YanhaoYang2/ECE-445-notebooks/README.md

# Team 9 Ant-weight 3D Printed Battlebot

A sub-2 lb antweight combat robot featuring a servo-driven lifting wedge, ESP32-S3 BLE wireless control, dual H-bridge motor drivers, and a fully 3D-printed PLA chassis: built for ECE 445 Senior Design at UIUC. The custom PCB integrates power regulation, drivetrain control, and weapon actuation into a compact, competition-ready platform.

Team members:
- Mig Umnakkittikul
- Yanhao Yang
- Yunhan Tian

## Results

[Battle Video](https://drive.google.com/file/d/1RE8FONN-sFi-dEDkxu0kXL-BYywnTr4P/view?resourcekey)

[Presentation](https://docs.google.com/presentation/d/1tjDH-47TegS7ervyMoe9hrtVM2WsI11a/edit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)

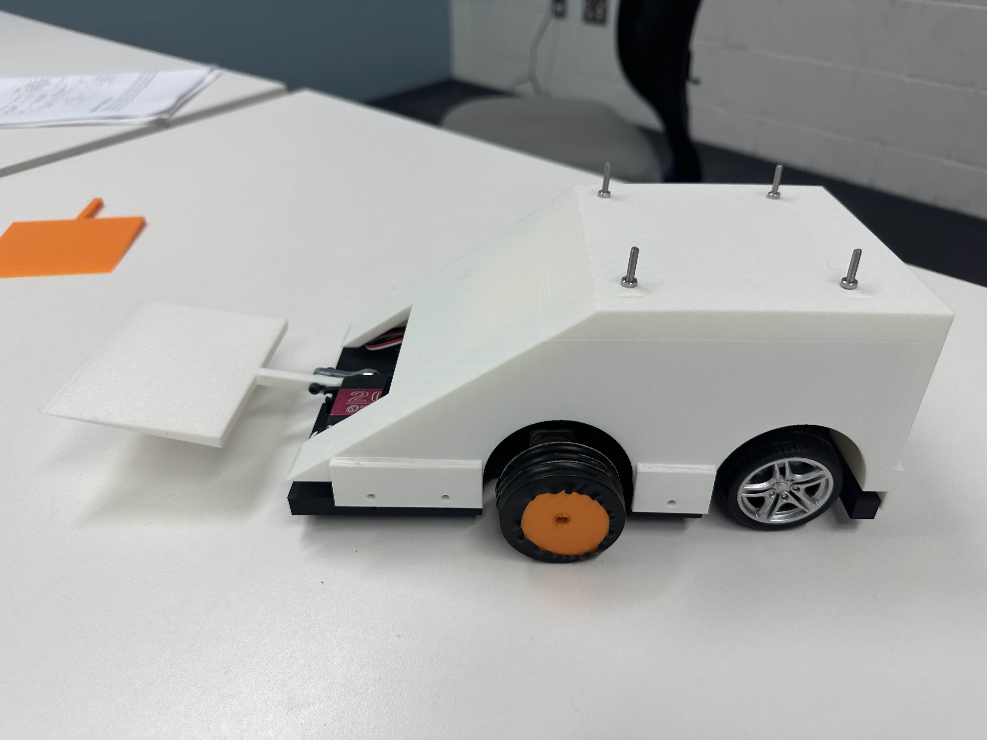
[picture p1: notebooks/Mig/finalbattlebot.jpg]
