YanhaoYang2/ECE-445-notebooks/boards/schematics/full_schematics.png

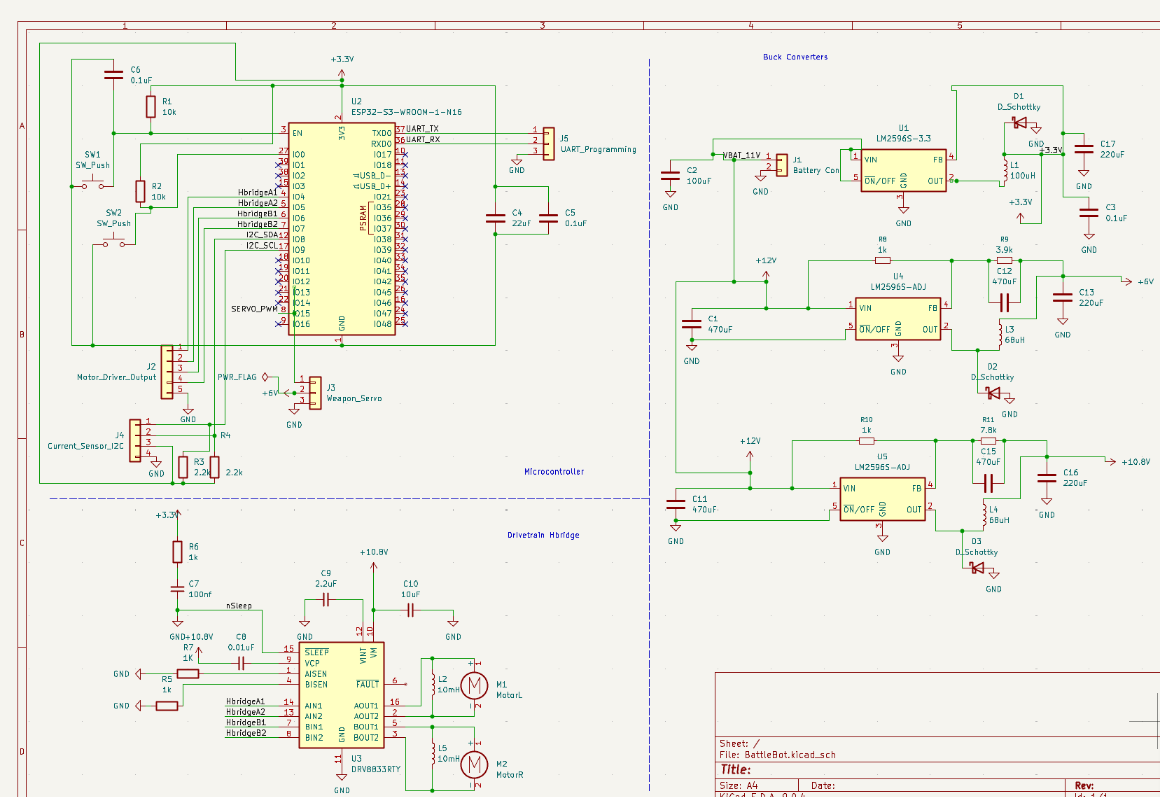
boards/schematics/full_schematics.png
