YanhaoYang2/ECE-445-notebooks/models/battlebotchassisbottom.png

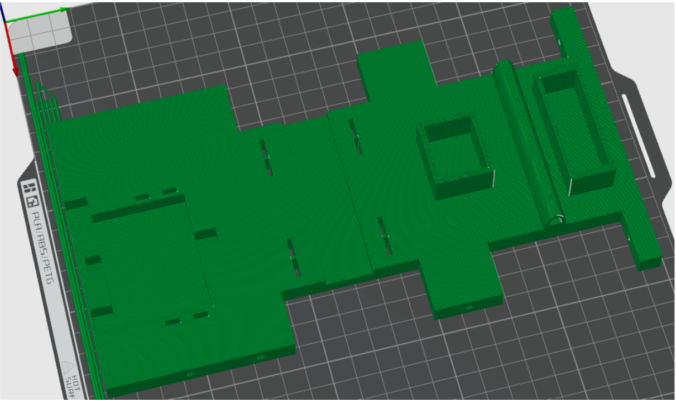
models/battlebotchassisbottom.png
