YanhaoYang2/ECE-445-notebooks/models/battlebotchassistop.png

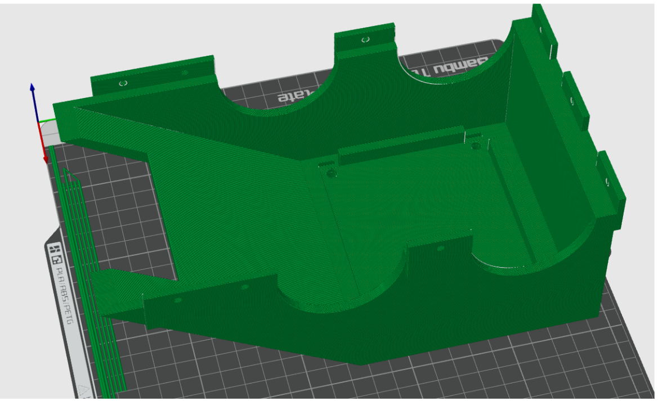
models/battlebotchassistop.png
