YanhaoYang2/ECE-445-notebooks/models/shovel_design.png

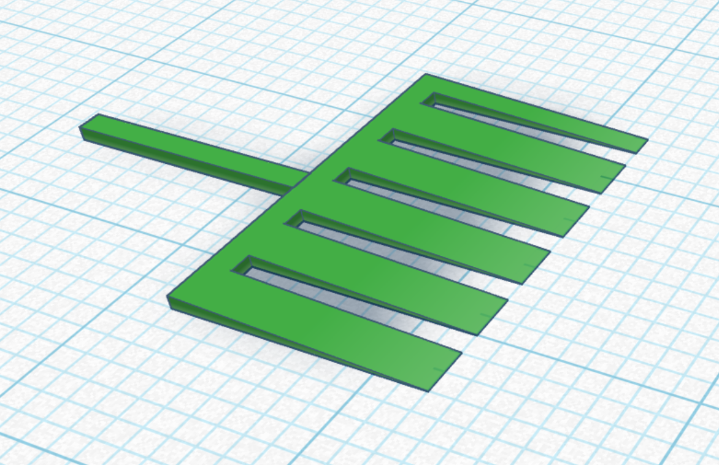
models/shovel_design.png
