YanhaoYang2/ECE-445-notebooks/models/weapon3d.png

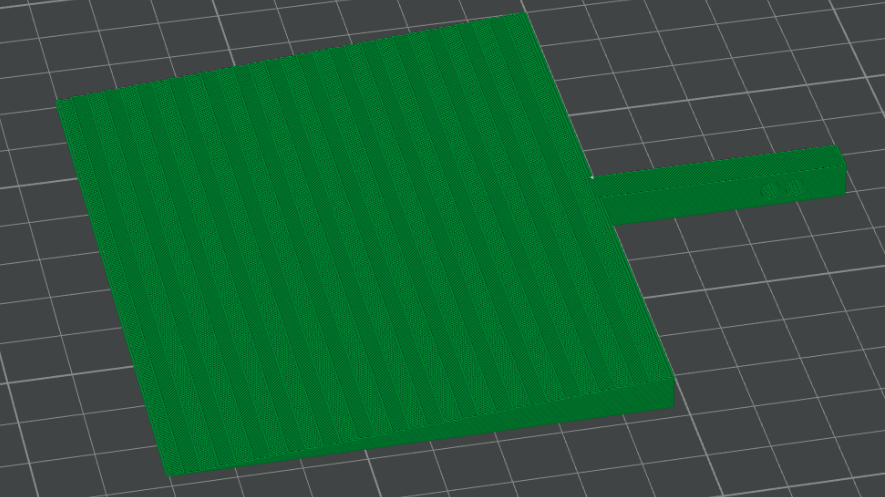
models/weapon3d.png
