YanhaoYang2/ECE-445-notebooks/notebooks/Mig/newfullpcb.png

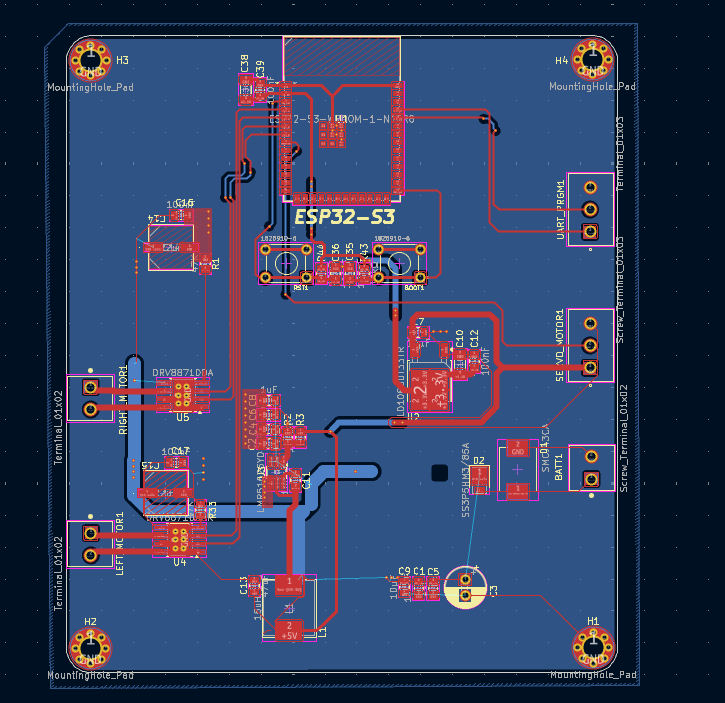
notebooks/Mig/newfullpcb.png
