YanhaoYang2/ECE-445-notebooks/models/printedweapon.png

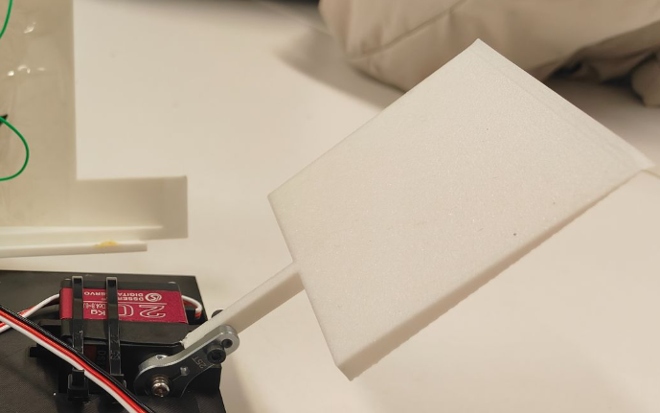
models/printedweapon.png
