YanhaoYang2/ECE-445-notebooks/boards/schematics/control_unit/battlebot.kicad_sch

## KiCad design boards/schematics/control_unit/battlebot.kicad_sch (2025-09-22)

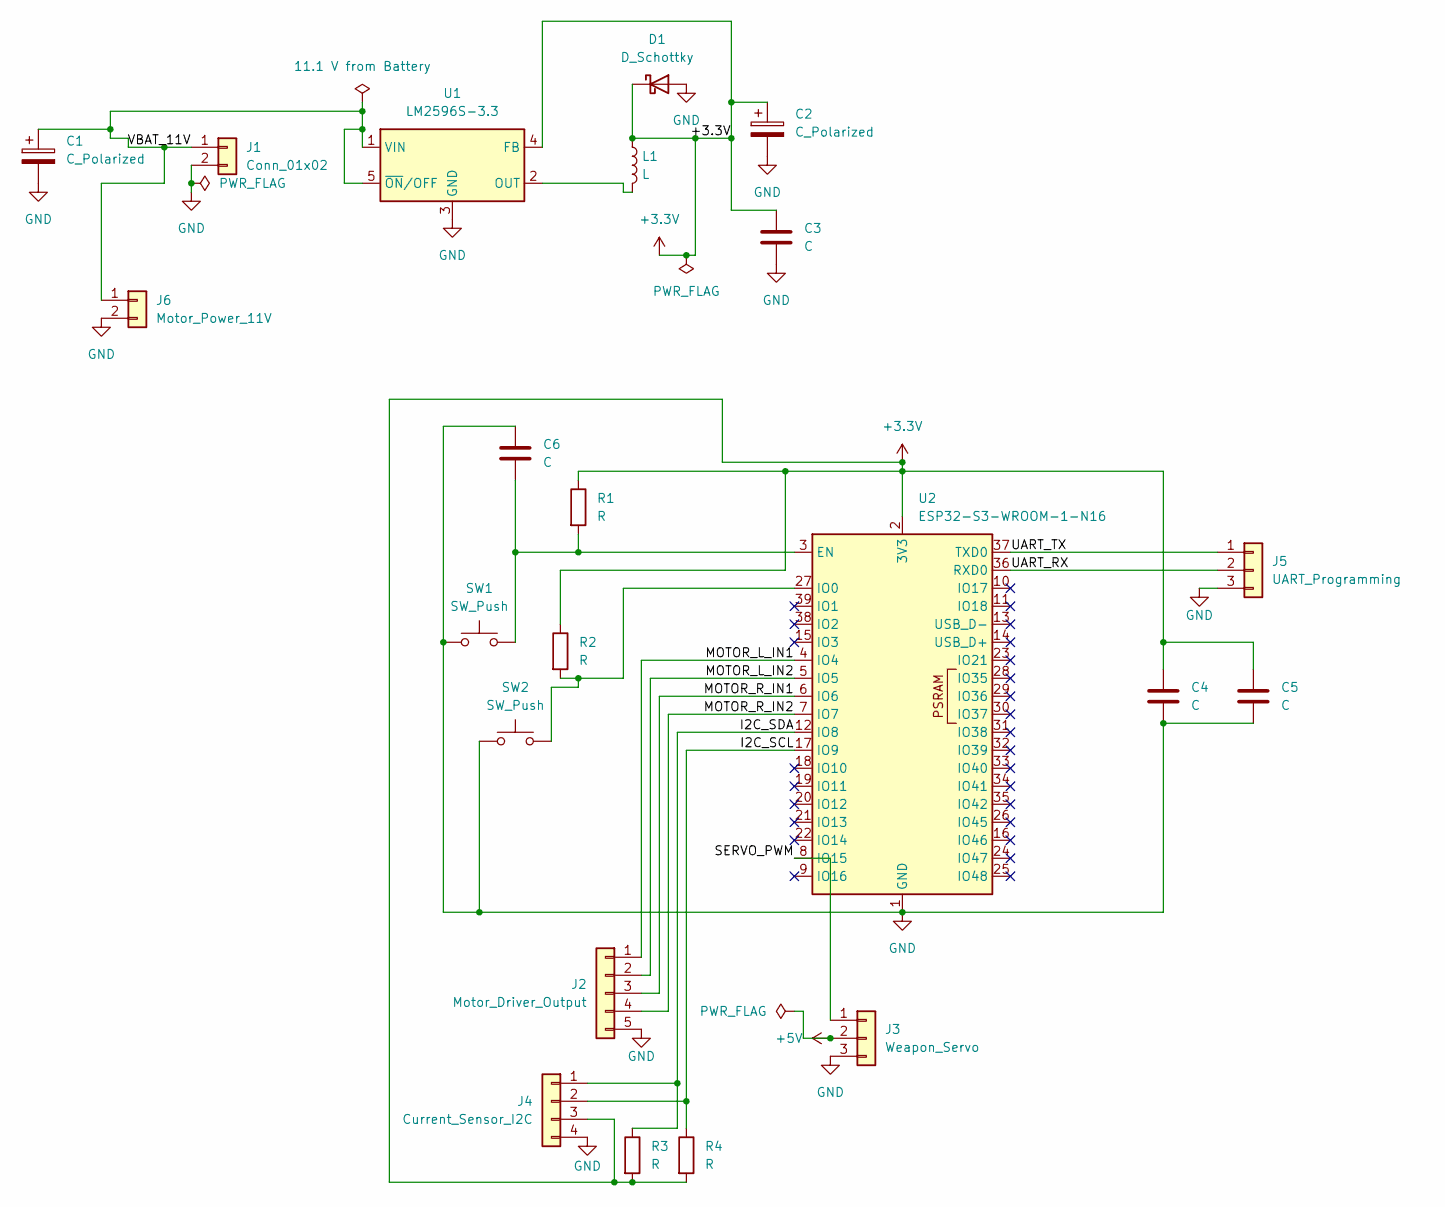
[picture p66: schematic battlebot.kicad_sch]

Parts:
C1, C2: C_Polarized
C3, C4, C5, C6: C
D1: D_Schottky
J1: Conn_01x02
J2: Motor_Driver_Output
J3: Weapon_Servo
J4: Current_Sensor_I2C
J5: UART_Programming
J6: Motor_Power_11V
L1: L
R1, R2, R3, R4: R
SW1, SW2: SW_Push
U1: LM2596S-3.3; TO-263-5_TabPin3
U2: ESP32-S3-WROOM-1-N16; ESP32-S3-WROOM-1

Connections:
+3.3V: C2.1, C3.1, C4.1, C5.1, D1.1 (K), J4.3, L1.1, R1.1, R2.1, R3.2, R4.2, U1.4 (FB), U2.2 (3V3)
+5V: J3.2
GND: C1.2, C2.2, C3.2, C4.2, C5.2, C6.1, D1.2 (A), J1.2, J2.5, J3.3, J4.4, J5.3, J6.2, SW1.1, SW2.1, U1.3 (GND), U2.1 (GND), U2.40 (GND), U2.41 (GND)
I2C_SCL: J4.2, R4.1, U2.17 (IO9)
I2C_SDA: J4.1, R3.1, U2.12 (IO8)
MOTOR_L_IN1: J2.1, U2.4 (IO4)
MOTOR_L_IN2: J2.2, U2.5 (IO5)
MOTOR_R_IN1: J2.3, U2.6 (IO6)
MOTOR_R_IN2: J2.4, U2.7 (IO7)
unnamed: C6.2, R1.2, SW1.2, U2.3 (EN)
unnamed: L1.2, U1.2 (OUT)
unnamed: R2.2, SW2.2, U2.27 (IO0)
SERVO_PWM: J3.1, U2.8 (IO15)
UART_RX: J5.2, U2.36 (RXD0)
UART_TX: J5.1, U2.37 (TXD0)
VBAT_11V: C1.1, J1.1, J6.1, U1.1 (VIN), U1.5 (~ON/OFF)
