YanhaoYang2/ECE-445-notebooks/(commit log)

2025-09-30 add images for control unit schematics
2025-09-30 add notes on control unit schematics design
2025-10-01 H bridge Schematics Update
2025-10-02 create boards folder with initial pcb design
    [battlebot.kicad_sch]
2025-10-06 code for motor control and current sensor
2025-10-12 add images for full schematics and routed pcb
2025-10-12 add notes for the first version of pcb done, combined schematics and routed pcb
2025-10-14 add pictures for new motor and servo used
2025-10-18 add images for 3d printed structures
2025-11-04 add image for pcb
2025-11-04 add some details of soldering and challenges faced
2025-11-10 add picture after soldering the components onto pcb
2025-11-10 add some details regarding soldered components and results of tests using multimeter
2025-11-12 add pictures for second pcb full schematics
2025-11-12 add details for second order pcb and simplification
2025-11-17 add pictures for the final pcb
2025-11-17 add notes for final pcb we are using
2025-11-28 images for final pcb and components assembly
2025-11-28 add notes for final pcb and assembly
