YanhaoYang2/ECE-445-notebooks/notebooks/Yunhan Tian/final1.jpg

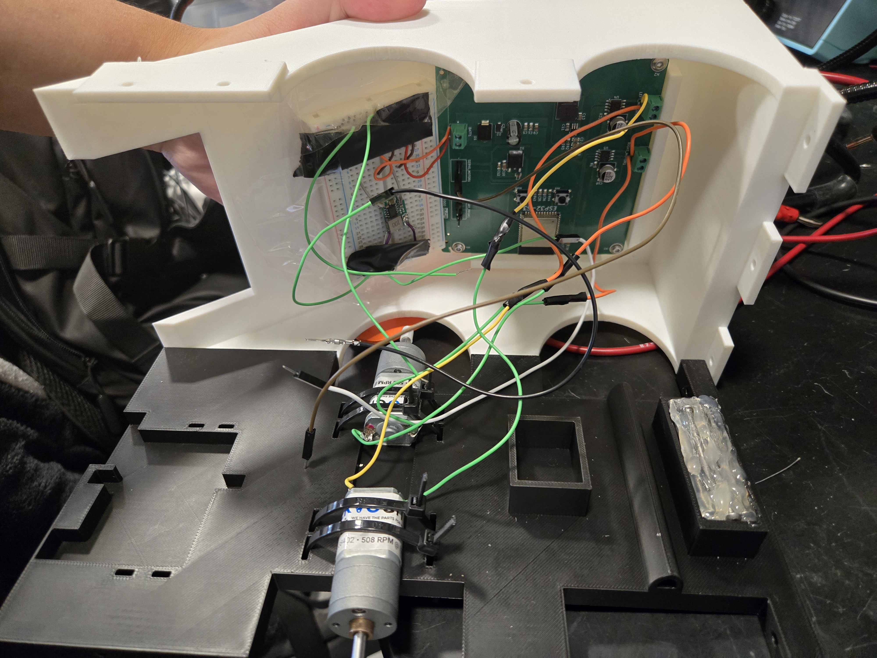
[picture p42: notebooks/Yunhan Tian/final1.jpg]
notebooks/Yunhan Tian/final1.jpg
